parkourlrc/pcb-LJBoxx--bigtolt-161d1cb5ca/tolt/full.step

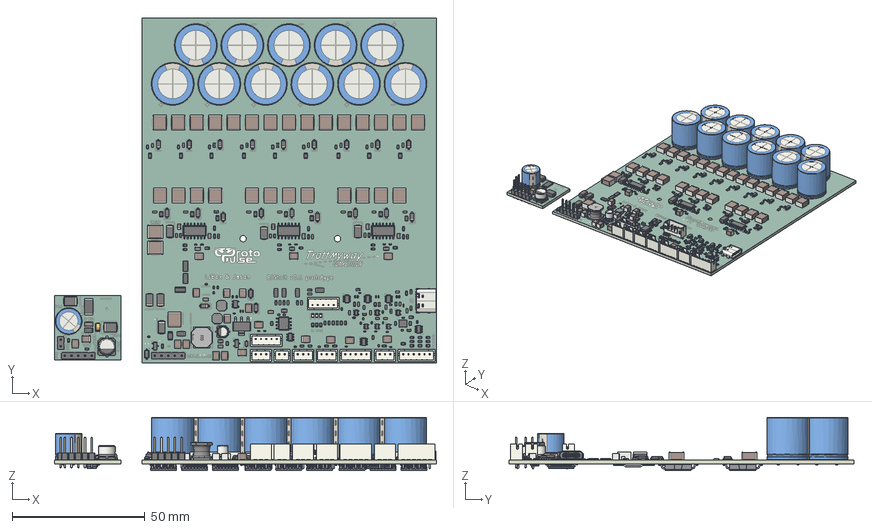
[picture p1: CAD file, 2026-05-21]
tolt/full.step
144.0 x 130.0 x 20.0 mm
C_0402_1005Metric x 45
D_SOD-123 x 22
SOT-353_SC-70-5 x 6
R_0603_1608Metric x 79
C_1210_3225Metric x 20
C_0603_1608Metric x 46
C_2220_5750Metric x 30
R_1206_3216Metric x 7
CP_Radial_D16.0mm_P7.50mm x 11
D_SOD-323F
R_0805_2012Metric x 18
LED_0603_1608Metric x 3
CP_EIA-3216-18_Kemet-A
D_SMA x 6
SOT-23-8 x 3
IND-SMD_L3.9-W3.9-1 x 2
PinHeader_1x02_P2.54mm_Vertical
JST_PH_B3B-PH-K_1x03_P2.00mm_Vertical x 4
R_0815_2038Metric x 3
CP_Elec_6.3x5.4
SOIC-8_3.9x4.9mm_P1.27mm
JST_PH_B2B-PH-K_1x02_P2.00mm_Vertical
SOT-23-6 x 3
SO-14_3.9x8.65mm_P1.27mm x 3
C_0805_2012Metric x 14
IND-SMD_L8.0-W8.0-H6.5_FNR80XXS
SOT-23 x 2
R_0402_1005Metric x 4
JST_PH_B5B-PH-K_1x05_P2.00mm_Vertical x 3
SOT-23-5
SOT-223
Bosch_LGA-14_3x2.5mm_P0.5mm
USB_C_Receptacle_GCT_USB4105-xx-A_16P_TopMnt_Horizontal
C_1206_3216Metric
PinHeader_1x05_P2.54mm_Vertical x 2
CP_Elec_4x5.4
JST_PH_B6B-PH-K_1x06_P2.00mm_Vertical
CP_Radial_D10.0mm_P2.50mm_P5.00mm
R_2512_6332Metric
D_SMB x 2
SOP120P1500X235-17N x 36
R5930 x 9
LQFP-64_10x10mm_P0.5mm
PowerIntegrations_SO-8C
Crystal_SMD_3225-4Pin_3.2x2.5mm
tolt_silkscreen x 2
tolt_soldermask x 2
tolt_PCB_1
tolt_PCB_2
