parkourlrc/pcb-LJBoxx--bigtolt-161d1cb5ca/tolt/3d/IND-SMD_L8.0-W8.0-H6.5_FNR80XXS.step

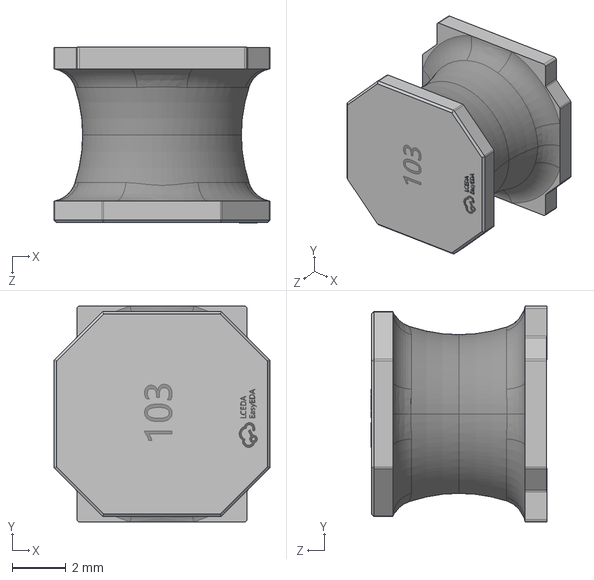
[picture p2: CAD file, 2026-05-21]
tolt/3d/IND-SMD_L8.0-W8.0-H6.5_FNR80XXS.step
8.00 x 8.00 x 6.52 mm
