parkourlrc/pcb-LJBoxx--bigtolt-161d1cb5ca/(list of files, cad)

Other CAD files:
tolt/.step
