parkourlrc/pcb-LJBoxx--bigtolt-161d1cb5ca/tolt/tolt.pdf

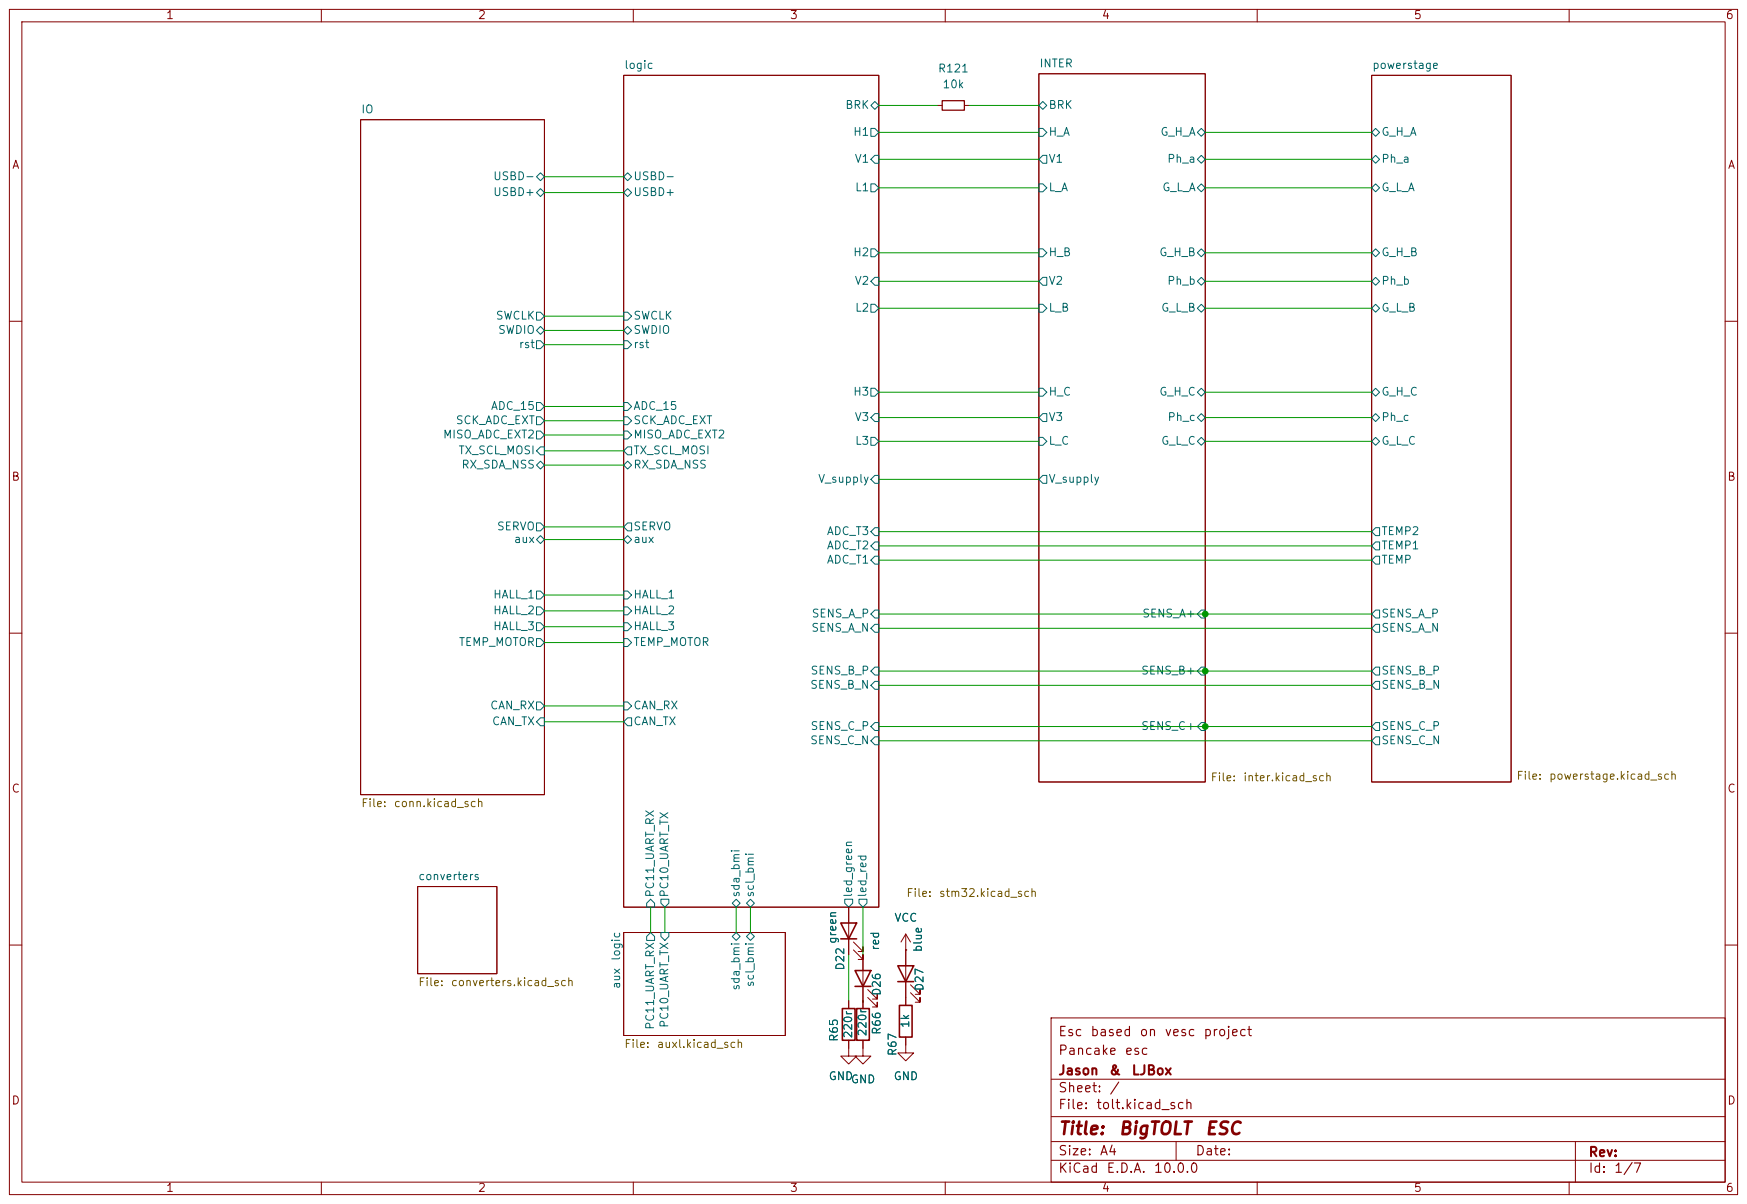
[picture p3: page 1]

SENS_B+

SENS_C+

Jason & LJBox Pancake esc Esc based on vesc project converters File: converters.kicad_sch

Size: A4 | Rev:
KiCad E.D.A. 10.0.0 | Id: 1/7

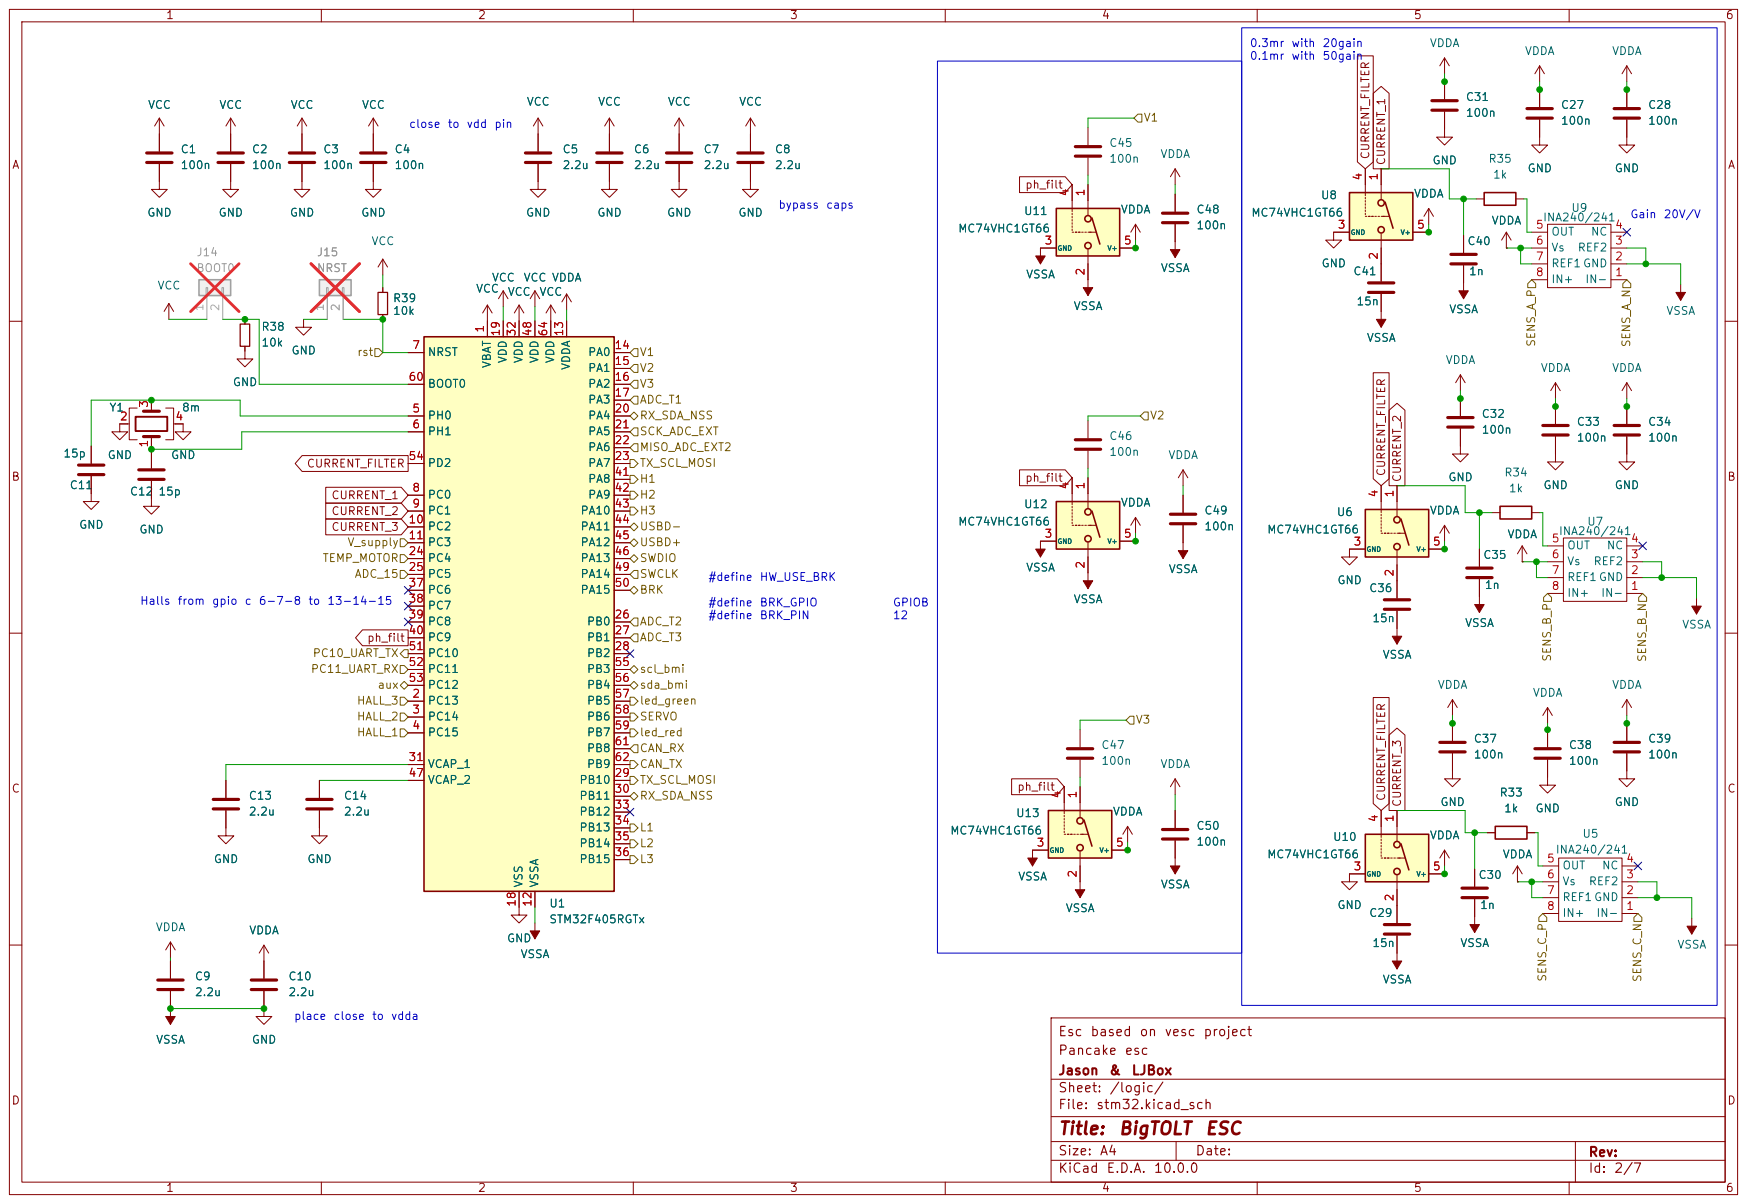
[picture p4: page 2]

close to vdd pin

place close to vdda

Jason & LJBox Pancake esc Esc based on vesc project

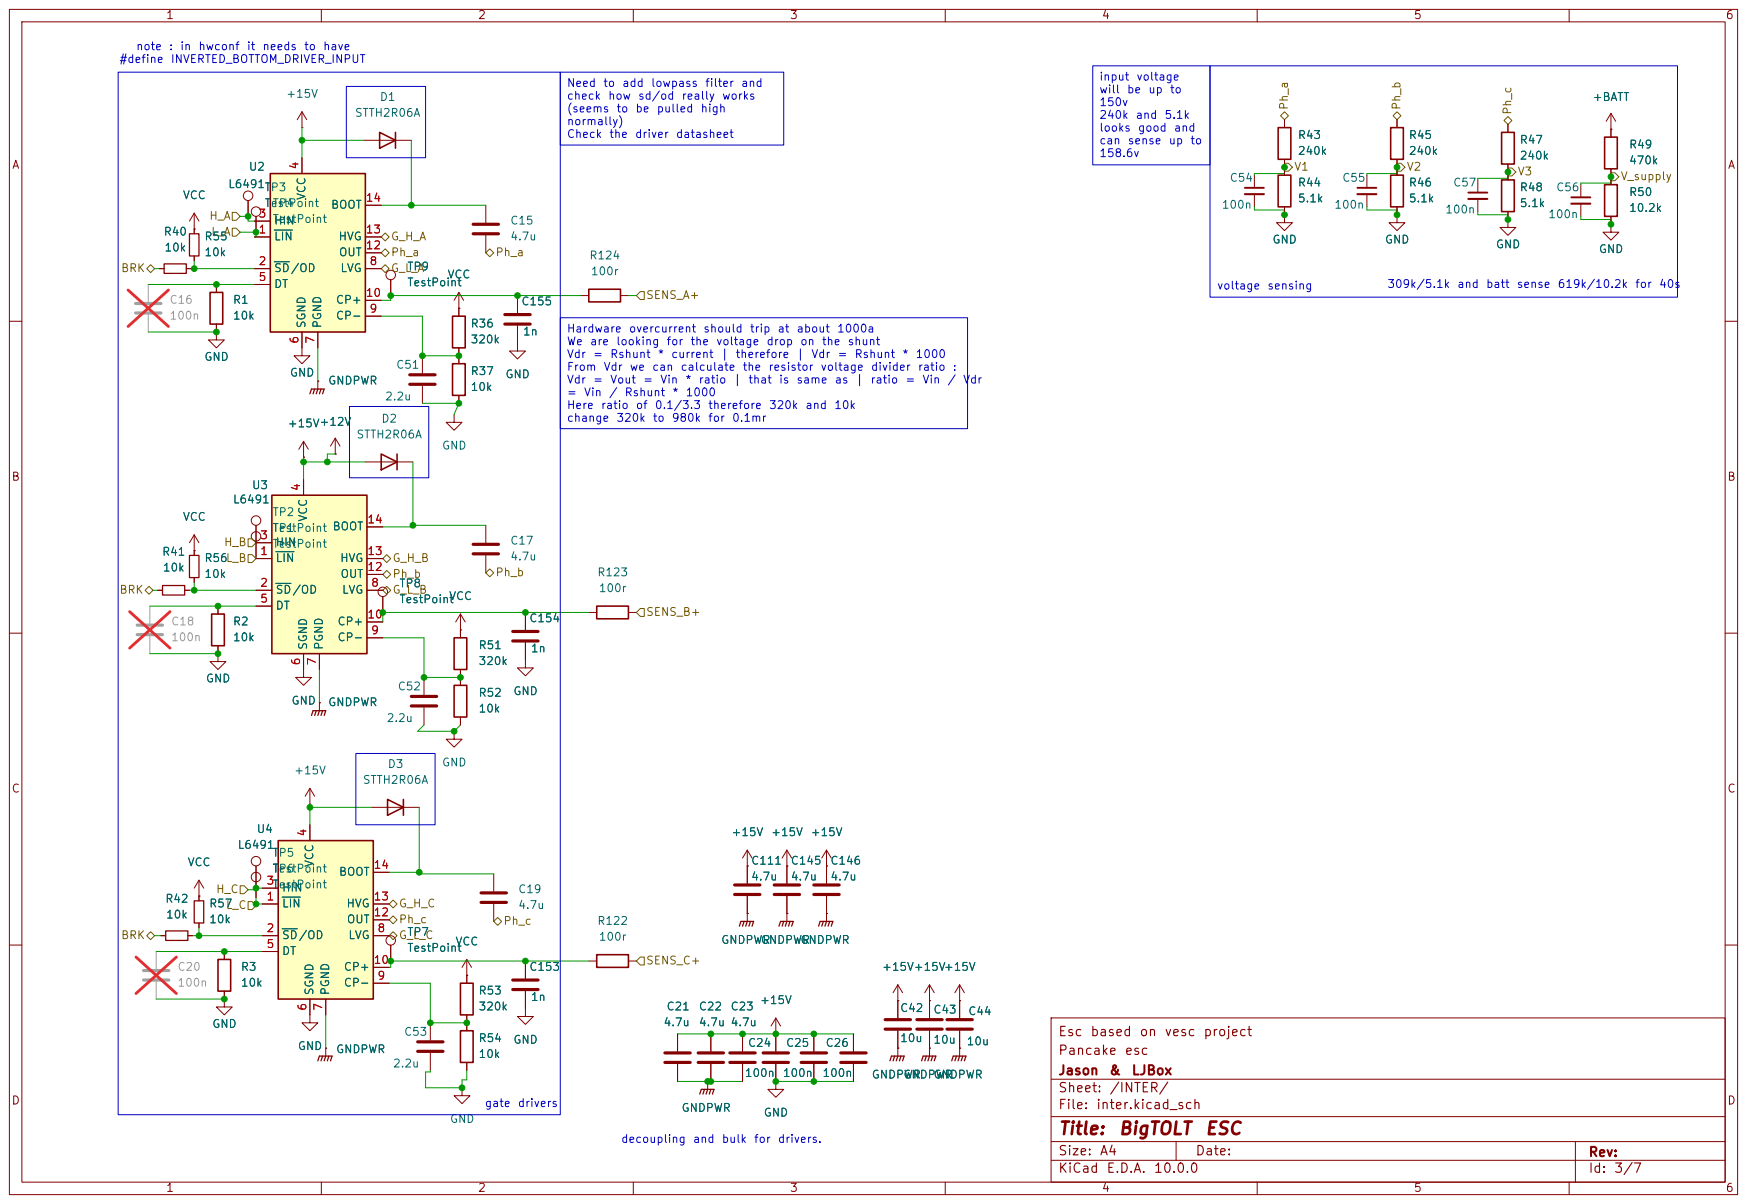
[picture p5: page 3]

note : in hwconf it needs to have
#define INVERTED_BOTTOM_DRIVER_INPUT

V1 Need to add lowpass filter and

input voltage will be up to 150v 240k and 5.1k looks good and | 240k R48 240k R48 5.1k GND 309k/5.1k and batt sense 619k/10.2k for 40s | 10.2k GND

check how sd/od really works (seems to be pulled high normally) Check the driver datasheet

can sense up to 158.6v Hardware overcurrent should trip at about 1000a We are looking for the voltage drop on the shunt Vdr = Rshunt * current | therefore | Vdr = Rshunt * 1000

From Vdr we can calculate the resistor voltage divider ratio : Vdr = Vout = Vin * ratio | that is same as | ratio = Vin / Vdr = Vin / Rshunt * 1000 Here ratio of 0.1/3.3 therefore 320k and 10k change 320k to 980k for 0.1mr gate drivers

Jason & LJBox Pancake esc Esc based on vesc project +15V C42

decoupling and bulk for drivers.

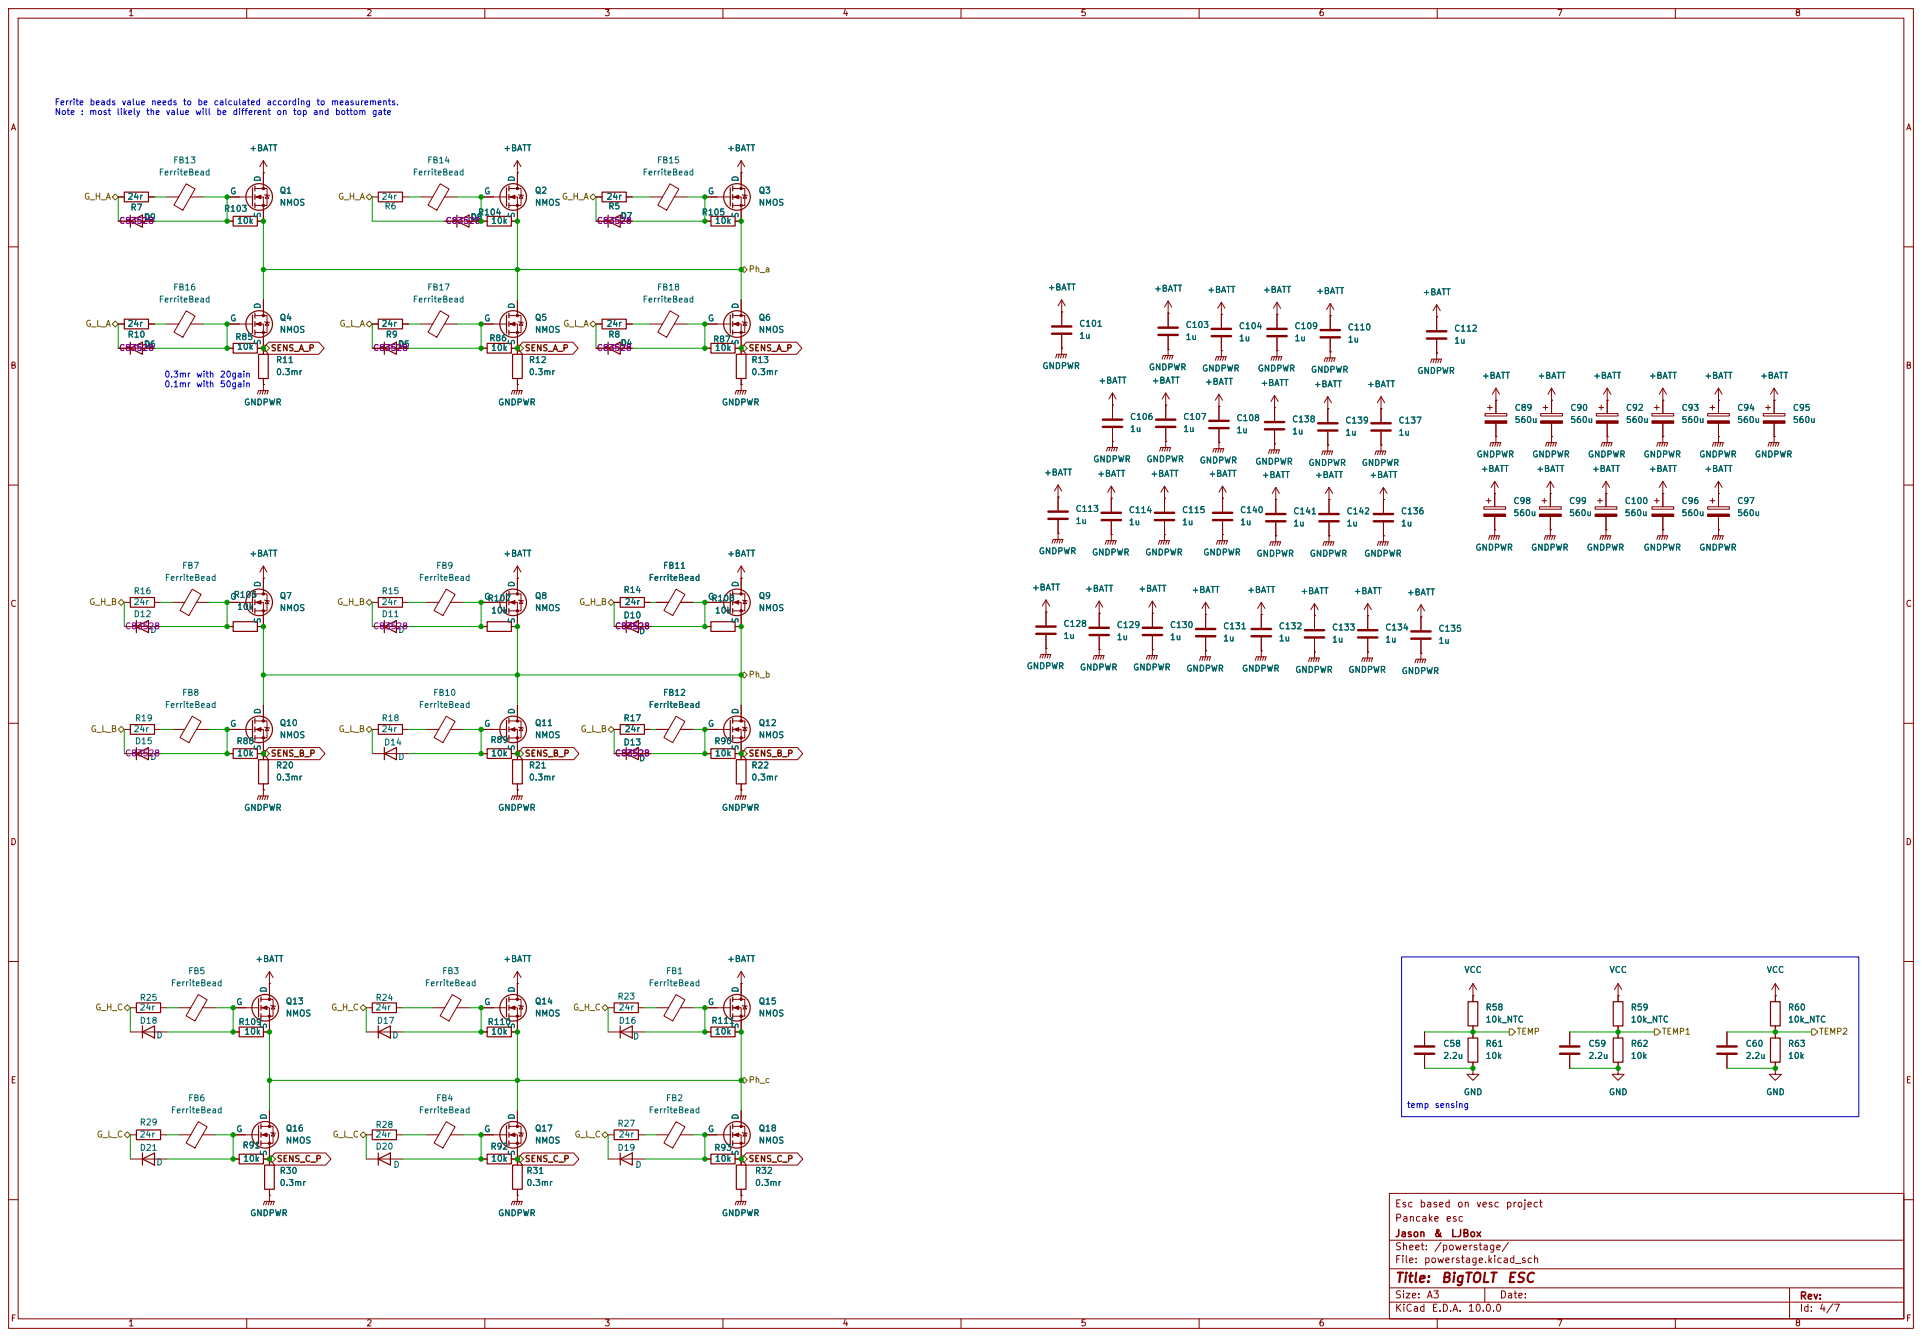
[picture p6: page 4]

Ferrite beads value needs to be calculated according to measurements.
Note : most likely the value will be different on top and bottom gate
FerriteBead +BATT Q2NMOS D

560u +BATT +BATT GNDPWR +BATT C138

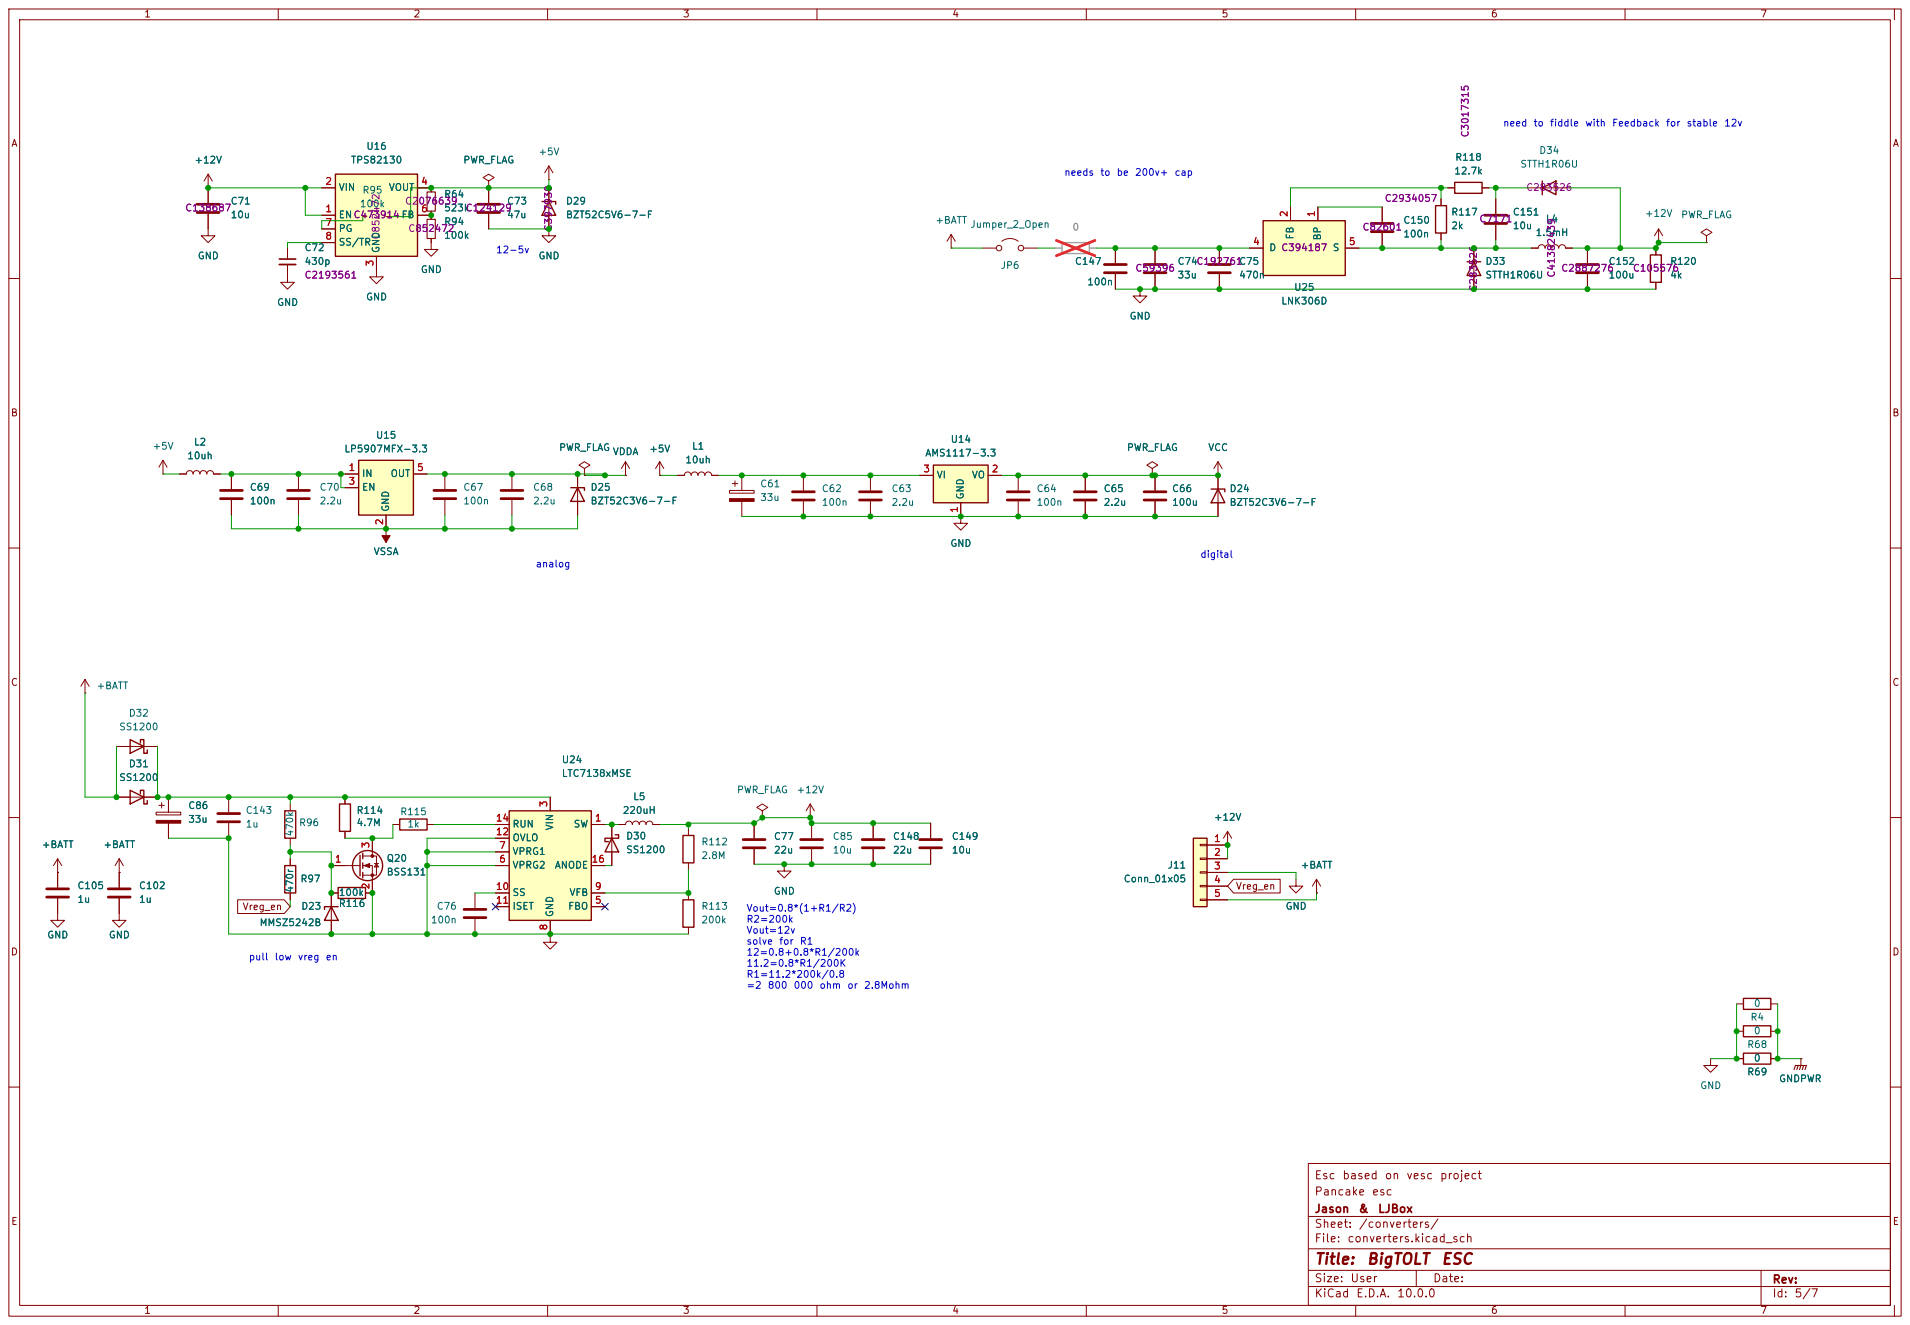
[picture p7: page 5]

need to fiddle with Feedback for stable 12v

pull low vreg en

Jason & LJBox Pancake esc Esc based on vesc project

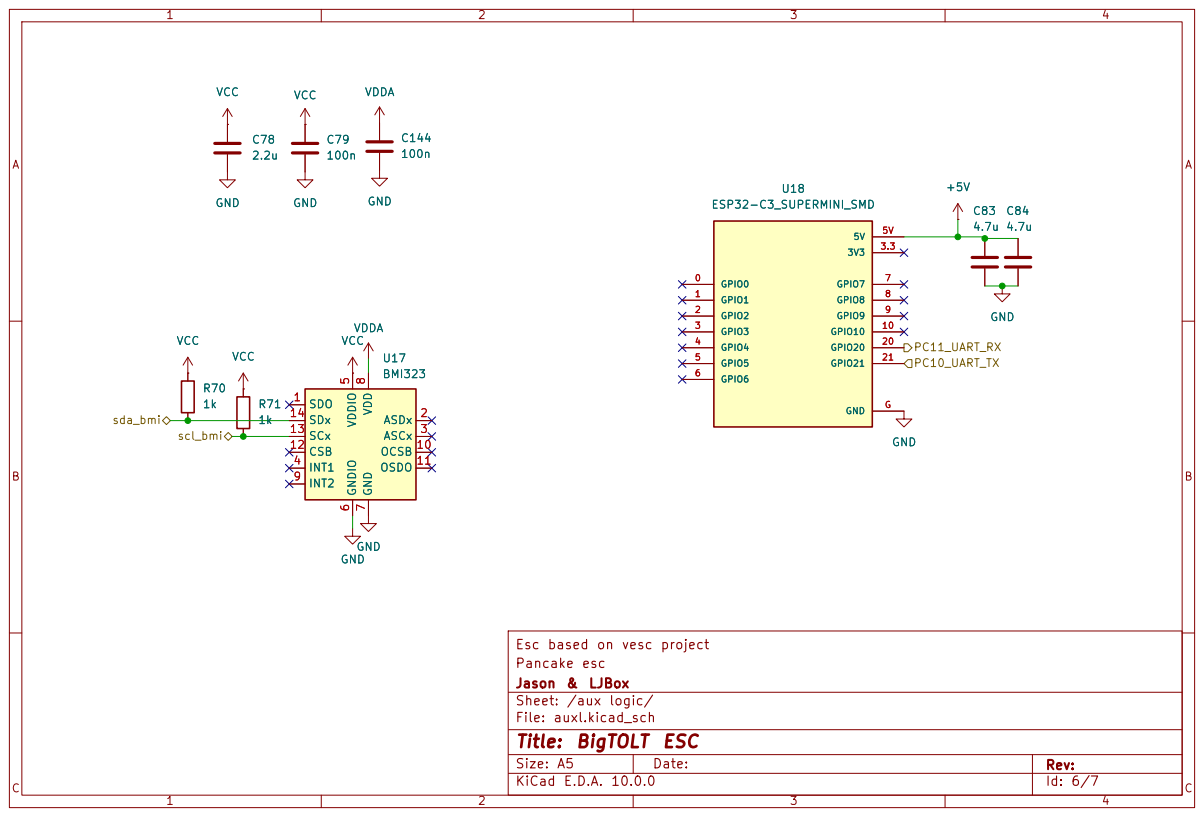
[picture p8: page 6]

SDO 1
Jason & LJBox Pancake esc Esc based on vesc project R71

Size: A5 | Rev: | C Date:
KiCad E.D.A. 10.0.0 | Id: 6/7

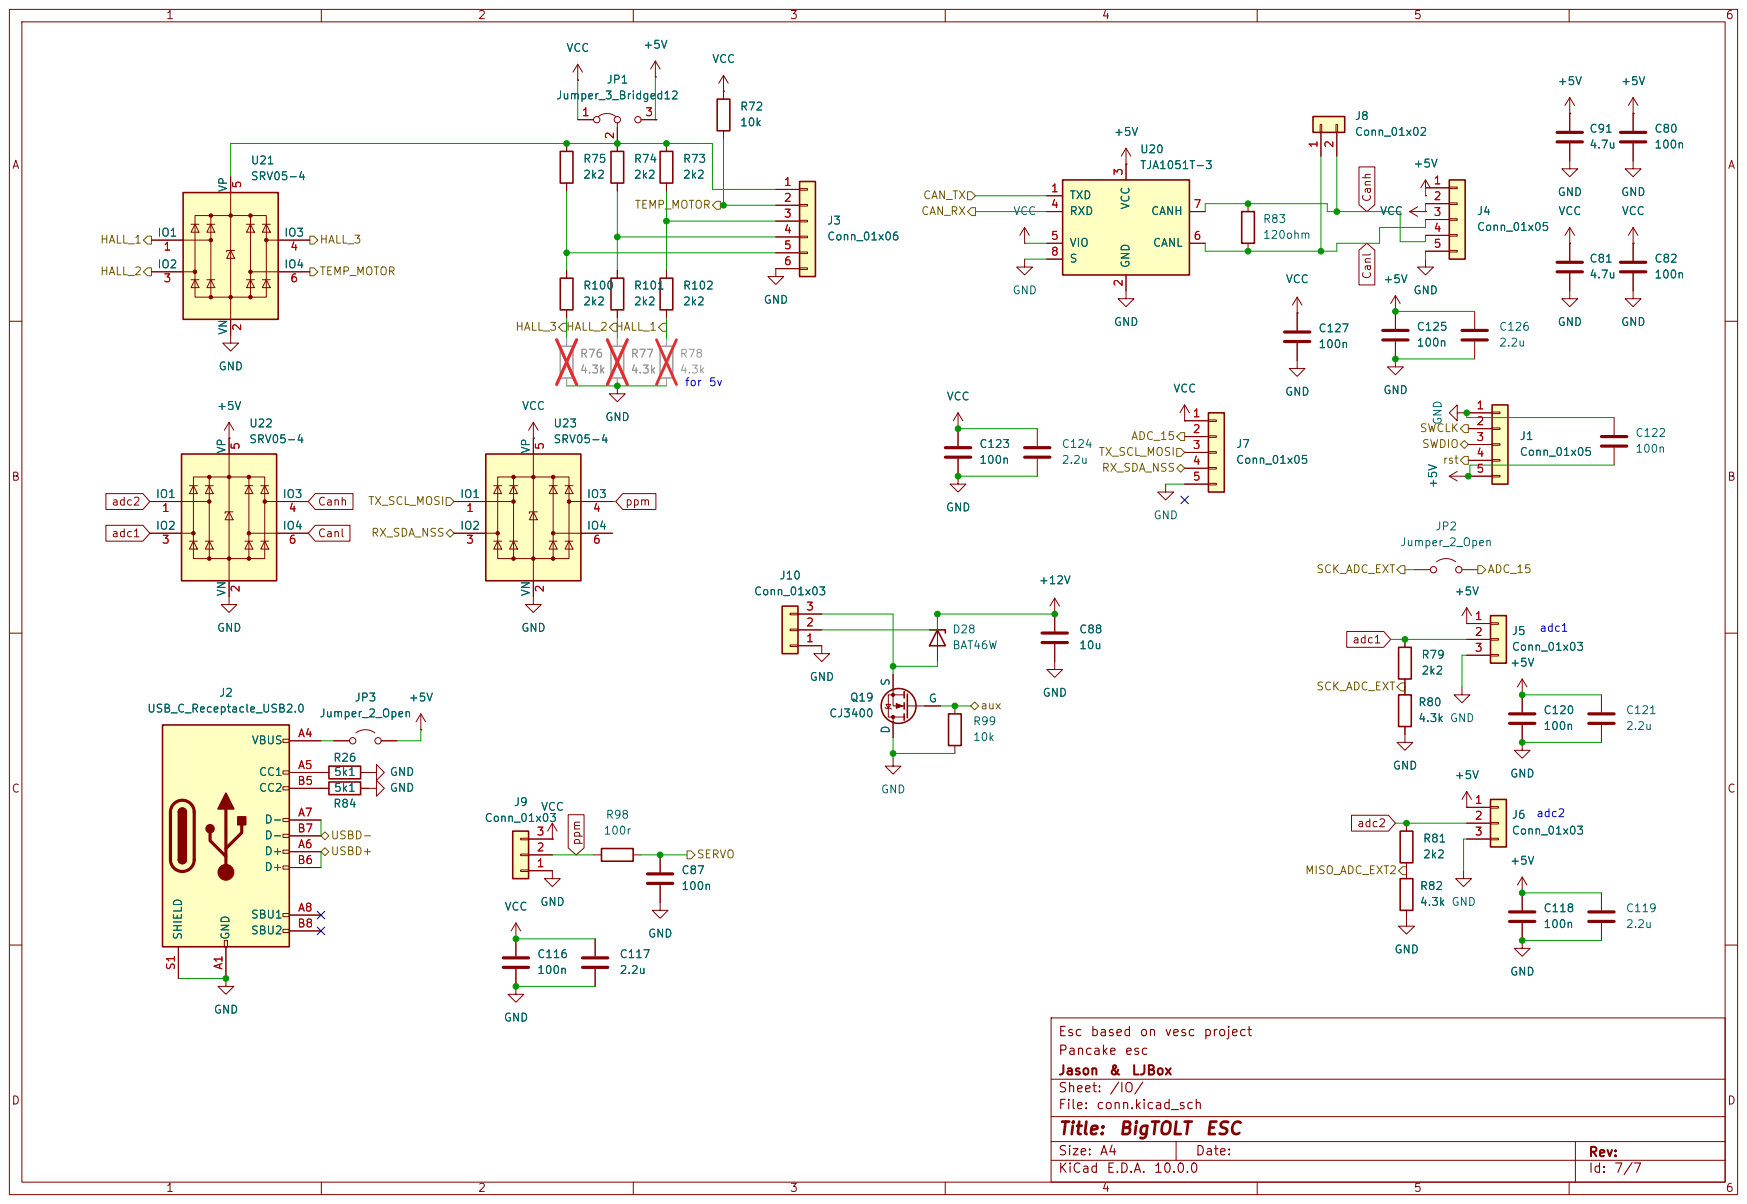
[picture p9: page 7]

5 5
6 6

Jason & LJBox Pancake esc Esc based on vesc project GND GND A1
Jumper_2_Open GND
