parkourlrc/pcb-LJBoxx--bigtolt-161d1cb5ca/tolt/tolt.kicad_pcb

## KiCad design tolt/tolt.kicad_pcb (2026-05-21)

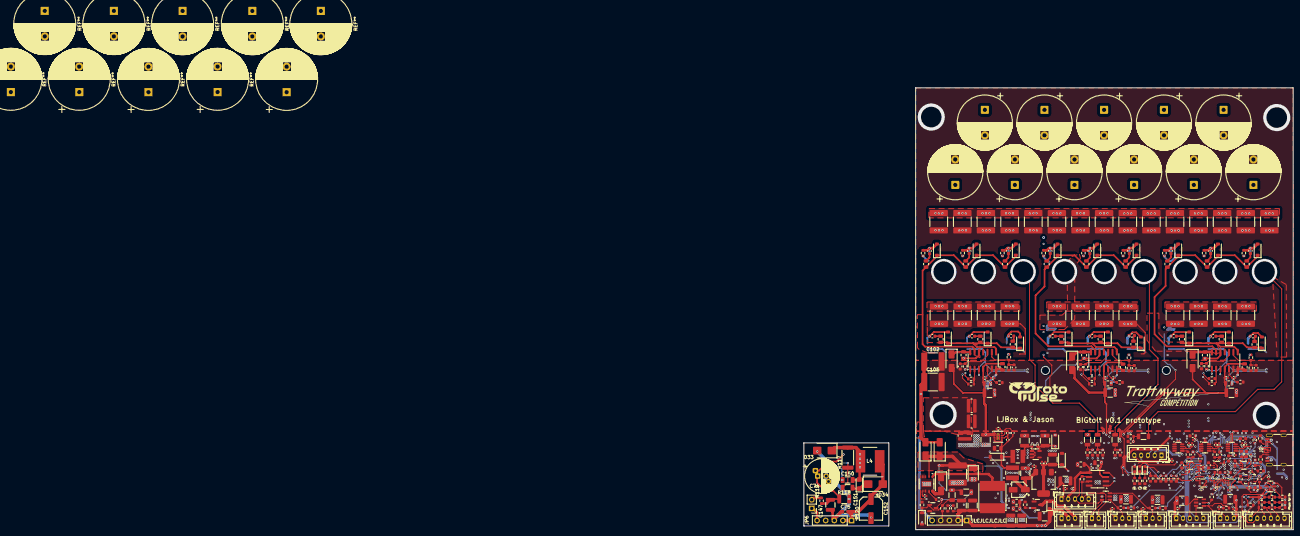
[picture p10: board tolt.kicad_pcb from above]

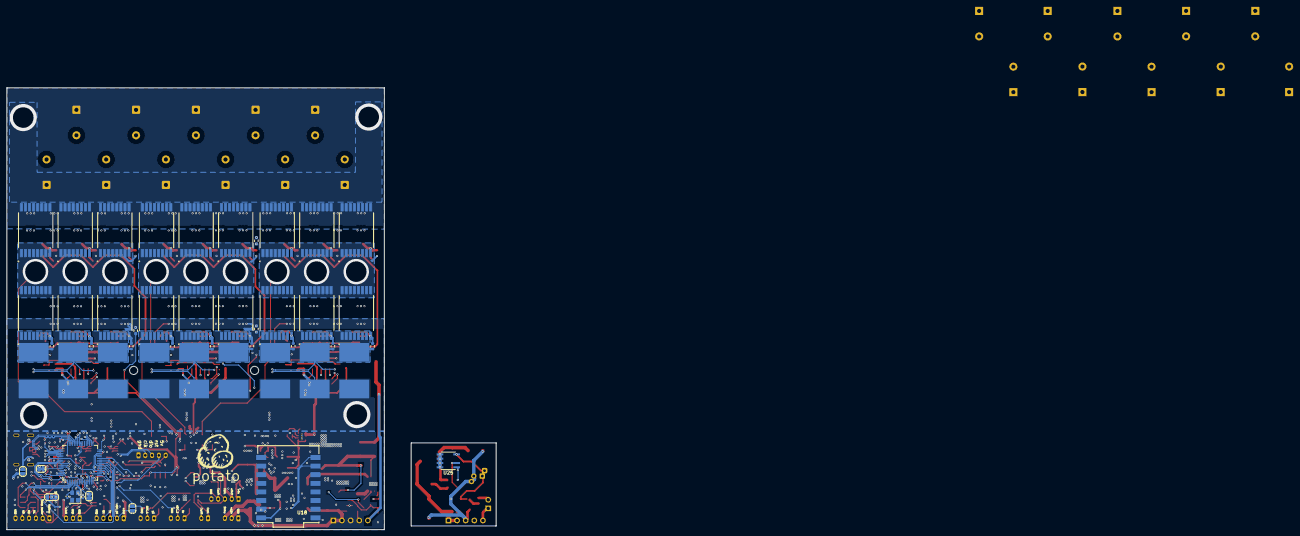
[picture p11: board tolt.kicad_pcb from below]

Board: 6 copper layers, 111.1 x 130.0 mm, 398 parts (50 on the bottom side), 164 nets.

Parts:
C1, C2, C3, C4, C24, C25, C26, C27, C28, C31, C32, C33, C34, C37, C38, C39, C45, C46, C47, C48, C49, C50, C76, C79, C80, C82, C87, C144: 100n; C_0402_1005Metric
C5, C6, C7, C8, C9, C10, C13, C14, C58, C59, C60, C78: 2.2uf; C_0603_1608Metric
C11, C12: 15p; C_0402_1005Metric
C15, C17, C19, C21, C22, C23, C81, C83, C84, C91, C111, C145, C146: 4.7u; C_0805_2012Metric
C16, C18, C20: 220nF; C_0402_1005Metric
C29, C36, C41: 15n; C_0603_1608Metric
C30, C35, C40, C51, C52, C53, C153, C154, C155: 1n; C_0603_1608Metric
C42, C43, C44, C71, C85, C88, C149: 10uF; C_1210_3225Metric
C54, C55, C56, C57: 100n; C_0603_1608Metric
C61: 33uF; CP_Elec_4x5.4
C62, C64, C67, C69, C116, C118, C120, C122, C123, C125, C127: 100nF; C_0402_1005Metric
C63, C65, C68, C70, C117, C119, C121, C124, C126: 2.2uF; C_1210_3225Metric
C66: 100uF; C_0402_1005Metric
C72: 430pF; R_0402_1005Metric
C73: 47uF; C_0805_2012Metric
C74: 33uF; CP_Radial_D10.0mm_P2.50mm_P5.00mm
C75: 470nF; C_1210_3225Metric
C77, C148: 22uF; C_1210_3225Metric
C86: 33uF; CP_EIA-3528-15_AVX-H
C89, C90, C92, C93, C94, C95, C96, C97, C98, C99, C100: 560u; CP_Radial_D16.0mm_P7.50mm
C101, C102, C103, C104, C105, C106, C107, C108, C109, C110, C112, C113, C114, C115, C128, C129, C130, C131, C132, C133, C134, C135, C136, C137, C138, C139, C140, C141, C142, C143: 1uf; C_2220_5750Metric
C147: 100n; C_1210_3225Metric
C150: 100nF; C_1206_3216Metric
C151: 10uF; CP_EIA-3216-18_Kemet-A
C152: 100uF; CP_Elec_6.3x5.4
D1, D2, D3: STTH2R06A; D_SMA
D4, D5, D6, D7, D8, D9, D10, D11, D12, D13, D14, D15, D16, D17, D18, D19, D20, D21: D; D_SOD-123
D22: green; LED_0603_1608Metric
D23: MMSZ5242B; D_SOD-123
D24, D25: BZT52C3V6-7-F; D_SOD-123
D26: red; LED_0603_1608Metric
D27: blue; LED_0603_1608Metric
D28: BAT46W; D_SOD-323F
D29: BZT52C5V6-7-F; D_SOD-123
D30, D31, D32: SS1200; D_SMA
D33, D34: STTH1R06U; D_SMB
FB1, FB2, FB3, FB4, FB5, FB6, FB7, FB8, FB9, FB10, FB11, FB12, FB13, FB14, FB15, FB16, FB17, FB18: FerriteBead; C_0603_1608Metric
J1, J4, J7: Conn_01x05; JST_PH_B5B-PH-K_1x05_P2.00mm_Vertical
J2: USB_C_Receptacle_USB2.0; USB_C_Receptacle_G-Switch_GT-USB-7010ASV
J3: Conn_01x06; JST_PH_B6B-PH-K_1x06_P2.00mm_Vertical
J5, J6, J9, J10: Conn_01x03; JST_PH_B3B-PH-K_1x03_P2.00mm_Vertical
J8: Conn_01x02; JST_PH_B2B-PH-K_1x02_P2.00mm_Vertical
J11, J11#2: Conn_01x05; PinHeader_1x05_P2.54mm_Vertical
J14: BOOT0; SolderJumper-2_P1.3mm_Open_RoundedPad1.0x1.5mm
J15: NRST; SolderJumper-2_P1.3mm_Open_RoundedPad1.0x1.5mm
JP1: Jumper_3_Bridged12; SolderJumper-3_P1.3mm_Bridged2Bar12_RoundedPad1.0x1.5mm
JP2, JP3: Jumper_2_Open; SolderJumper-2_P1.3mm_Open_RoundedPad1.0x1.5mm
JP6: Jumper_2_Open; PinHeader_1x02_P2.54mm_Vertical
L1, L2: 10uh; IND-SMD_L3.9-W3.9-1
L4: 1.5mH; L_Bourns_SRN8040TA
L5: 220uH; IND-SMD_L8.0-W8.0_FNR80XXS
Q1, Q2, Q3, Q4, Q5, Q6, Q7, Q8, Q9, Q10, Q11, Q12, Q13, Q14, Q15, Q16, Q17, Q18: NMOS; HDSOP-16-2
Q19: CJ3400; SOT-23
Q20: BSS131; SOT-23
R1, R2, R3, R37, R38, R39, R40, R41, R42, R52, R54, R55, R56, R57, R61, R62, R63, R72, R85, R86, R87, R88, R89, R90, R91, R92, R93, R99, R103, R104, R105, R106, R107, R108, R109, R110, R111, R121: 10k; R_0603_1608Metric
R4, R68, R69: 0; R_0815_2038Metric
R5, R6, R7, R8, R9, R10, R14, R15, R16, R17, R18, R19, R23, R24, R25, R27, R28, R29: 24r; R_0805_2012Metric
R11, R12, R13, R20, R21, R22, R30, R31, R32: 0.3mr; R5930
R26, R84: 5k1; R_0603_1608Metric
R33, R34, R35, R67, R70, R71, R115: 1k; R_0603_1608Metric
R36, R51, R53: 320k; R_0603_1608Metric
R43, R45, R47: 240k; R_1206_3216Metric
R44, R46, R48: 5.1k; R_0603_1608Metric
R49, R96: 470k; R_1206_3216Metric
R50: 10.2k; R_0603_1608Metric
R58, R59, R60: 10k_NTC; R_0603_1608Metric_Pad0.98x0.95mm_HandSolder
R64: 523k; R_0402_1005Metric
R65, R66: 220r; R_0603_1608Metric
R73, R74, R75, R79, R81, R100, R101, R102: 2k2; R_0603_1608Metric
R76, R77, R78, R80, R82: 4.3k; R_0603_1608Metric
R83: 120ohm; R_0603_1608Metric
R94, R95: 100k; R_0402_1005Metric
R97: 470r; R_0603_1608Metric
R98, R122, R123, R124: 100r; R_0603_1608Metric
R112: 2.8M; R_0603_1608Metric
R113: 200k; R_0603_1608Metric
R114: 4.7M; R_1206_3216Metric
R116: 100k; R_0603_1608Metric
R117: 2k; R_2512_6332Metric
R118: 12.7k; R_1206_3216Metric
R119: 0; R_0603_1608Metric
R120: 4k; R_0603_1608Metric
U1: STM32F405RGTx; LQFP-64_10x10mm_P0.5mm
U2, U3, U4: L6491; SO-14_3.9x8.65mm_P1.27mm
U5, U7, U9: INA240/241; SOT-23-8
U6, U8, U10, U11, U12, U13: MC74VHC1GT66; SOT-353_SC-70-5
U14: AMS1117-3.3; SOT-223-3_TabPin2
U15: LP5907MFX-3.3; SOT-23-5
U16: TPS82130; Texas_SIL0008D_MicroSiP-8-1EP_2.8x3mm_P0.65mm_EP1.1x1.9mm_T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
U17: BMI323; Bosch_LGA-14_3x2.5mm_P0.5mm
U18: ESP32-C3_SUPERMINI_SMD; MODULE_ESP32-C3_SUPERMINI
U20: TJA1051T-3; SOIC-8_3.9x4.9mm_P1.27mm
U21, U22, U23: SRV05-4; SOT-23-6
U24: LTC7138xMSE; Analog_MSOP-12-16-1EP_3x4.039mm_P0.5mm_EP1.651x2.845mm
U25: LNK306D; PowerIntegrations_SO-8C
Y1: 8m; Crystal_SMD_3225-4Pin_3.2x2.5mm

Connections:
+5V: C73.2, C80.2, C83.2, C84.2, C91.2, C118.1, C119.1, C120.1, C121.1, C122.2, C125.1, C126.1, D29.1 (K), J1.5, J4.1, J5.1, J6.1, JP1.3 (B), JP3.2 (B), L1.1, L2.1, R64.1, R95.2, U16.4 (VOUT), U16.5 (VOUT), U18.5V, U20.3 (VCC), U22.5 (VP)
+12V: C21.2, C22.2, C23.2, C24.2, C25.2, C26.2, C42.1, C43.1, C44.1, C71.2, C77.2, C85.2, C88.2, C111.2, C145.2, C146.2, C148.2, C149.2, C152.1, D1.2 (A), D2.2 (A), D3.2 (A), D28.1 (K), D34.2 (A), J10.2, J11.1, J11.2, J11#2.1, J11#2.2, L4.2, L5.2, R112.1, R120.1, U2.4 (VCC), U3.4 (VCC), U4.4 (VCC), U16.1 (EN), U16.2 (VIN)
+BATT: C89.1, C90.1, C92.1, C93.1, C94.1, C95.1, C96.1, C97.1, C98.1, C99.1, C100.1, C101.1, C102.1, C103.1, C104.1, C105.1, C106.1, C107.1, C108.1, C109.1, C110.1, C112.1, C113.1, C114.1, C115.1, C128.1, C129.1, C130.1, C131.1, C132.1, C133.1, C134.1, C135.1, C136.1, C137.1, C138.1, C139.1, C140.1, C141.1, C142.1, D31.2 (A), D32.2 (A), J11.5, J11#2.5, JP6.1 (A), Q1.1 (D), Q2.1 (D), Q3.1 (D), Q7.1 (D), Q8.1 (D), Q9.1 (D), Q13.1 (D), Q14.1 (D), Q15.1 (D), R49.1
/INTER/BRK: R40.2, R41.1, R42.1, R121.1
/INTER/G_H_A: D7.1 (K), D8.1 (K), D9.1 (K), R5.1, R6.1, R7.2, U2.13 (HVG)
/INTER/G_H_B: D10.1 (K), D11.1 (K), D12.1 (K), R14.1, R15.1, R16.2, U3.13 (HVG)
/INTER/G_H_C: D16.1 (K), D17.1 (K), D18.1 (K), R23.1, R24.1, R25.2, U4.13 (HVG)
/INTER/G_L_A: D4.1 (K), D5.1 (K), D6.1 (K), R8.1, R9.1, R10.2, U2.8 (LVG)
/INTER/G_L_B: D13.1 (K), D14.1 (K), D15.1 (K), R17.1, R18.1, R19.2, U3.8 (LVG)
/INTER/G_L_C: D19.1 (K), D20.1 (K), D21.1 (K), R27.1, R28.1, R29.2, U4.8 (LVG)
/INTER/H_A: U1.41 (PA8), U2.3 (HIN)
/INTER/H_B: U1.42 (PA9), U3.3 (HIN)
/INTER/H_C: U1.43 (PA10), U4.3 (HIN)
/INTER/L_A: U1.34 (PB13), U2.1 (~LIN)
/INTER/L_B: U1.35 (PB14), U3.1 (~LIN)
/INTER/L_C: U1.36 (PB15), U4.1 (~LIN)
/INTER/Ph_a: C15.2, Q1.3 (S), Q2.3 (S), Q3.3 (S), Q4.1 (D), Q5.1 (D), Q6.1 (D), R43.1, R103.1, R104.2, R105.1, U2.12 (OUT)
/INTER/Ph_b: C17.2, Q7.3 (S), Q8.3 (S), Q9.3 (S), Q10.1 (D), Q11.1 (D), Q12.1 (D), R45.1, R106.1, R107.2, R108.1, U3.12 (OUT)
/INTER/Ph_c: C19.2, Q13.3 (S), Q14.3 (S), Q15.3 (S), Q16.1 (D), Q17.1 (D), Q18.1 (D), R47.1, R109.1, R110.2, R111.1, U4.12 (OUT)
/INTER/V1: C45.2, C54.1, R43.2, R44.1, U1.14 (PA0)
/INTER/V2: C46.2, C55.1, R45.2, R46.1, U1.15 (PA1)
/INTER/V3: C47.2, C57.1, R47.2, R48.1, U1.16 (PA2)
/INTER/V_supply: C56.1, R49.2, R50.1, U1.11 (PC3)
/IO/ADC_15: J7.2, JP2.2 (B), U1.25 (PC5)
/IO/CAN_RX: U1.61 (PB8), U20.4 (RXD)
/IO/CAN_TX: U1.62 (PB9), U20.1 (TXD)
/IO/HALL_1: R78.2, R102.1, U1.4 (PC15), U21.1 (IO1)
/IO/HALL_2: R77.2, R101.1, U1.3 (PC14), U21.3 (IO2)
/IO/HALL_3: R76.2, R100.1, U1.2 (PC13), U21.4 (IO3)
/IO/MISO_ADC_EXT2: R81.1, R82.2, U1.22 (PA6)
/IO/RX_SDA_NSS: J7.4, U1.20 (PA4), U1.30 (PB11), U23.3 (IO2)
/IO/SCK_ADC_EXT: JP2.1 (A), R79.1, R80.2, U1.21 (PA5)
/IO/SERVO: C87.2, R98.1, U1.58 (PB6)
/IO/SWCLK: J1.2, U1.49 (PA14)
/IO/SWDIO: J1.3, U1.46 (PA13)
/IO/TEMP_MOTOR: J3.2, R72.1, U1.24 (PC4), U21.6 (IO4)
/IO/TX_SCL_MOSI: J7.3, U1.23 (PA7), U1.29 (PB10), U23.1 (IO1)
/IO/USBD+: J2.A6 (D+), J2.B6 (D+), U1.45 (PA12)
/IO/USBD-: J2.A7 (D-), J2.B7 (D-), U1.44 (PA11)
/IO/aux: Q19.2 (G), R99.2, U1.53 (PC12)
/IO/rst: J1.4, J15.2, R39.2, U1.7 (NRST)
/aux logic/PC10_UART_TX: U1.51 (PC10), U18.21 (GPIO21)
/aux logic/PC11_UART_RX: U1.52 (PC11), U18.20 (GPIO20)
/aux logic/scl_bmi: R71.2, U1.55 (PB3), U17.13 (SCx)
/aux logic/sda_bmi: R70.2, U1.56 (PB4), U17.14 (SDx)
/logic/ADC_T1: C58.1, R58.2, R61.1, U1.17 (PA3)
/logic/ADC_T2: C59.1, R59.2, R62.1, U1.26 (PB0)
/logic/ADC_T3: C60.1, R60.2, R63.1, U1.27 (PB1)
/logic/BRK: R121.2, U1.50 (PA15)
/logic/led_green: D22.2 (A), U1.57 (PB5)
/logic/led_red: D26.2 (A), U1.59 (PB7)
CURRENT_1: C40.1, R35.2, U1.8 (PC0), U8.1
CURRENT_2: C35.1, R34.2, U1.9 (PC1), U6.1
CURRENT_3: C30.1, R33.2, U1.10 (PC2), U10.1
CURRENT_FILTER: U1.54 (PD2), U6.4, U8.4, U10.4
Canh: J4.4, J8.2, R83.1, U20.7 (CANH), U22.4 (IO3)
Canl: J4.3, J8.1, R83.2, U20.6 (CANL), U22.6 (IO4)
GND: C1.1, C2.1, C3.1, C4.1, C5.1, C6.1, C7.1, C8.1, C9.1, C10.1, C11.2, C12.2, C13.1, C14.1, C16.1, C18.1, C20.1, C24.1, C25.1, C26.1, C27.1, C28.1, C29.2, C30.2, C31.1, C32.1, C33.1, C34.1, C35.2, C36.2, C37.1, C38.1, C39.1, C40.2, C41.2, C48.1, C49.1, C50.1, C51.2, C52.2, C53.2, C54.2, C55.2, C56.2, C57.2, C58.2, C59.2, C60.2, C61.2, C62.2, C63.2, C64.2, C65.2, C66.2, C67.2, C68.2, C69.2, C70.2, C71.1, C72.2, C73.1, C74.2, C75.2, C76.1, C77.1, C78.1, C79.1, C80.1, C81.1, C82.1, C83.1, C84.1, C85.1, C86.2, C87.1, C88.1, C91.1, C102.2, C105.2, C116.2, C117.2, C118.2, C119.2, C120.2, C121.2, C122.1, C123.2, C124.2, C125.2, C126.2, C127.2, C143.2, C144.1, C147.2, C148.1, C149.1, C152.2, C153.2, C154.2, C155.2, D23.2 (A), D24.2 (A), D25.2 (A), D29.2 (A), D33.2 (A), J1.1, J2.A1 (GND), J2.A12 (GND), J2.B1 (GND), J2.B12 (GND), J2.S1 (SHIELD), J3.6, J4.5, J5.3, J6.3, J7.5, J9.1, J10.1, J11.3, J11#2.3, J15.1, Q19.1 (D), Q20.2 (S), R1.2, R2.2, R3.2, R4.2, R26.1, R37.2, R38.2, R44.2, R46.2, R48.2, R50.2, R52.2, R54.2, R61.2, R62.2, R63.2, R65.1, R66.1, R67.1, R68.1, R69.1, R76.1, R77.1, R78.1, R80.1, R82.1, R84.1, R94.2, R99.1, R113.2, R116.1, R120.2, U1.12 (VSSA), U1.18 (VSS), U1.63 (VSS), U2.6 (SGND), U3.6 (SGND), U4.6 (SGND), U5.2 (GND), U5.3 (REF2), U6.3 (GND), U7.2 (GND), U7.3 (REF2), U8.3 (GND), U9.2 (GND), U9.3 (REF2), U10.3 (GND), U11.2, U11.3 (GND), U12.2, U12.3 (GND), U13.2, U13.3 (GND), U14.1 (GND), U15.2 (GND), U16.3 (GND), U16.9 (GND), U17.6 (GNDIO), U17.7 (GND), U18.G (GND), U20.2 (GND), U20.8 (S), U21.2 (VN), U22.2 (VN), U23.2 (VN), U24.6 (VPRG2), U24.7 (VPRG1), U24.8 (GND), U24.12 (OVLO), U24.17 (GND), Y1.2, Y1.4
GNDPWR: C21.1, C22.1, C23.1, C42.2, C43.2, C44.2, C89.2, C90.2, C92.2, C93.2, C94.2, C95.2, C96.2, C97.2, C98.2, C99.2, C100.2, C101.2, C103.2, C104.2, C106.2, C107.2, C108.2, C109.2, C110.2, C111.1, C112.2, C113.2, C114.2, C115.2, C128.2, C129.2, C130.2, C131.2, C132.2, C133.2, C134.2, C135.2, C136.2, C137.2, C138.2, C139.2, C140.2, C141.2, C142.2, C145.1, C146.1, R4.1, R11.2, R12.2, R13.2, R20.2, R21.2, R22.2, R30.2, R31.2, R32.2, R68.2, R69.2, U2.7 (PGND), U3.7 (PGND), U4.7 (PGND)
unnamed: C29.1, U10.2
unnamed: C36.1, U6.2
unnamed: C41.1, U8.2
unnamed: C45.1, U11.1
unnamed: C46.1, U12.1
unnamed: C47.1, U13.1
unnamed: C15.1, D1.1 (K), U2.14 (BOOT)
unnamed: C17.1, D2.1 (K), U3.14 (BOOT)
unnamed: C19.1, D3.1 (K), U4.14 (BOOT)
unnamed: D4.2 (A), FB18.2, Q6.2 (G), R87.2
unnamed: D5.2 (A), FB17.2, Q5.2 (G), R86.2
unnamed: D6.2 (A), FB16.2, Q4.2 (G), R85.2
unnamed: D7.2 (A), FB15.2, Q3.2 (G), R105.2
unnamed: D8.2 (A), FB14.2, Q2.2 (G), R104.1
unnamed: D9.2 (A), FB13.2, Q1.2 (G), R103.2
unnamed: D10.2 (A), FB11.2, Q9.2 (G), R108.2
unnamed: D11.2 (A), FB9.2, Q8.2 (G), R107.1
unnamed: D12.2 (A), FB7.2, Q7.2 (G), R106.2
unnamed: D13.2 (A), FB12.2, Q12.2 (G), R90.2
unnamed: D14.2 (A), FB10.2, Q11.2 (G), R89.2
unnamed: D15.2 (A), FB8.2, Q10.2 (G), R88.2
unnamed: D16.2 (A), FB1.2, Q15.2 (G), R111.2
unnamed: D17.2 (A), FB3.2, Q14.2 (G), R110.1
unnamed: D18.2 (A), FB5.2, Q13.2 (G), R109.2
unnamed: D19.2 (A), FB2.2, Q18.2 (G), R93.2
unnamed: D20.2 (A), FB4.2, Q17.2 (G), R92.2
unnamed: D21.2 (A), FB6.2, Q16.2 (G), R91.2
unnamed: D22.1 (K), R65.2
unnamed: D23.1 (K), Q20.1 (G), R96.1, R97.2, R116.2
unnamed: D26.1 (K), R66.2
unnamed: D27.1 (K), R67.2
unnamed: D28.2 (A), J10.3, Q19.3 (S)
unnamed: D30.2 (A), U24.16 (ANODE)
unnamed: D30.1 (K), L5.1, U24.1 (SW)
unnamed: C86.1, C143.1, D31.1 (K), D32.1 (K), R96.2, R114.1, U24.3 (VIN)
unnamed: C150.2, C151.2, D33.1 (K), L4.1, R117.2, U25.5 (S), U25.6 (S), U25.7 (S), U25.8 (S)
unnamed: C151.1, D34.1 (K), R118.2
unnamed: FB1.1, R23.2
unnamed: FB2.1, R27.2
unnamed: FB3.1, R24.2
unnamed: FB4.1, R28.2
unnamed: FB5.1, R25.1
unnamed: FB6.1, R29.1
unnamed: FB7.1, R16.1
unnamed: FB8.1, R19.1
unnamed: FB9.1, R15.2
unnamed: FB10.1, R18.2
unnamed: FB11.1, R14.2
unnamed: FB12.1, R17.2
unnamed: FB13.1, R7.1
unnamed: FB14.1, R6.2
unnamed: FB15.1, R5.2
unnamed: FB16.1, R10.1
unnamed: FB17.1, R9.2
unnamed: FB18.1, R8.2
unnamed: J2.A5 (CC1), R26.2
unnamed: J2.B5 (CC2), R84.2
unnamed: J3.1, JP1.2 (C), R73.2, R74.2, R75.2, U21.5 (VP)
unnamed: J3.3, R73.1, R102.2
unnamed: J3.4, R74.1, R101.2
unnamed: J3.5, R75.1, R100.2
unnamed: J14.2, R38.1, U1.60 (BOOT0)
unnamed: J2.A4 (VBUS), J2.A9 (VBUS), J2.B4 (VBUS), J2.B9 (VBUS), JP3.1 (A)
unnamed: JP6.2 (B), R119.1
unnamed: Q20.3 (D), R114.2, R115.1
unnamed: C11.1, U1.5 (PH0), Y1.3
unnamed: C12.1, U1.6 (PH1), Y1.1
unnamed: C13.2, U1.31 (VCAP_1)
unnamed: C14.2, U1.47 (VCAP_2)
unnamed: C155.1, R124.2, U2.10 (CP+)
unnamed: C51.1, R36.2, R37.1, U2.9 (CP-)
unnamed: C16.2, R1.1, U2.5 (DT)
unnamed: R40.1, R55.2, U2.2 (~SD/OD)
unnamed: C154.1, R123.2, U3.10 (CP+)
unnamed: C52.1, R51.2, R52.1, U3.9 (CP-)
unnamed: C18.2, R2.1, U3.5 (DT)
unnamed: R41.2, R56.2, U3.2 (~SD/OD)
unnamed: C153.1, R122.2, U4.10 (CP+)
unnamed: C53.1, R53.2, R54.1, U4.9 (CP-)
unnamed: C20.2, R3.1, U4.5 (DT)
unnamed: R42.2, R57.2, U4.2 (~SD/OD)
unnamed: R33.1, U5.5 (OUT)
unnamed: R34.1, U7.5 (OUT)
unnamed: R35.1, U9.5 (OUT)
unnamed: C61.1, C62.1, C63.1, L1.2, U14.3 (VI)
unnamed: C69.1, C70.1, L2.2, U15.1 (IN), U15.3 (EN)
unnamed: R64.2, R94.1, U16.6 (FB)
unnamed: R95.1, U16.7 (PG)
unnamed: C72.1, U16.8 (SS/TR)
unnamed: R115.2, U24.14 (RUN)
unnamed: C76.2, U24.10 (SS)
unnamed: R112.2, R113.1, U24.9 (VFB)
unnamed: C150.1, U25.1 (BP)
unnamed: C74.1, C75.1, C147.1, R119.2, U25.4 (D)
unnamed: R117.1, R118.1, U25.2 (FB)
SENS_A_P: Q4.3 (S), Q5.3 (S), Q6.3 (S), R11.1, R12.1, R13.1, R85.1, R86.1, R87.1, R124.1, U9.8 (IN+)
SENS_B_P: Q10.3 (S), Q11.3 (S), Q12.3 (S), R20.1, R21.1, R22.1, R88.1, R89.1, R90.1, R123.1, U7.8 (IN+)
SENS_C_P: Q16.3 (S), Q17.3 (S), Q18.3 (S), R30.1, R31.1, R32.1, R91.1, R92.1, R93.1, R122.1, U5.8 (IN+)
VCC: C1.2, C2.2, C3.2, C4.2, C5.2, C6.2, C7.2, C8.2, C64.1, C65.1, C66.1, C78.2, C79.2, C81.2, C82.2, C116.1, C117.1, C123.1, C124.1, C127.1, D24.1 (K), D27.2 (A), J4.2, J7.1, J9.3, J14.1, JP1.1 (A), R36.1, R39.1, R51.1, R53.1, R55.1, R56.1, R57.1, R58.1, R59.1, R60.1, R70.1, R71.1, R72.2, U1.1 (VBAT), U1.19 (VDD), U1.32 (VDD), U1.48 (VDD), U1.64 (VDD), U14.2 (VO), U17.5 (VDDIO), U20.5 (VIO), U23.5 (VP)
VDDA: C9.2, C10.2, C27.2, C28.2, C31.2, C32.2, C33.2, C34.2, C37.2, C38.2, C39.2, C48.2, C49.2, C50.2, C67.1, C68.1, C144.2, D25.1 (K), U1.13 (VDDA), U5.6 (Vs), U5.7 (REF1), U6.5 (V+), U7.6 (Vs), U7.7 (REF1), U8.5 (V+), U9.6 (Vs), U9.7 (REF1), U10.5 (V+), U11.5 (V+), U12.5 (V+), U13.5 (V+), U15.5 (OUT), U17.8 (VDD)
Vreg_en: J11.4, J11#2.4, R97.1
adc1: J5.2, R79.2, U22.3 (IO2)
adc2: J6.2, R81.2, U22.1 (IO1)
ph_filt: U1.40 (PC9), U11.4, U12.4, U13.4
ppm: J9.2, R98.2, U23.4 (IO3)
